iralabdisco/otto_stm32/electronics/otto_shield/otto_shield.kicad_pcb

## KiCad design electronics/otto_shield/otto_shield.kicad_pcb (2020-03-15)

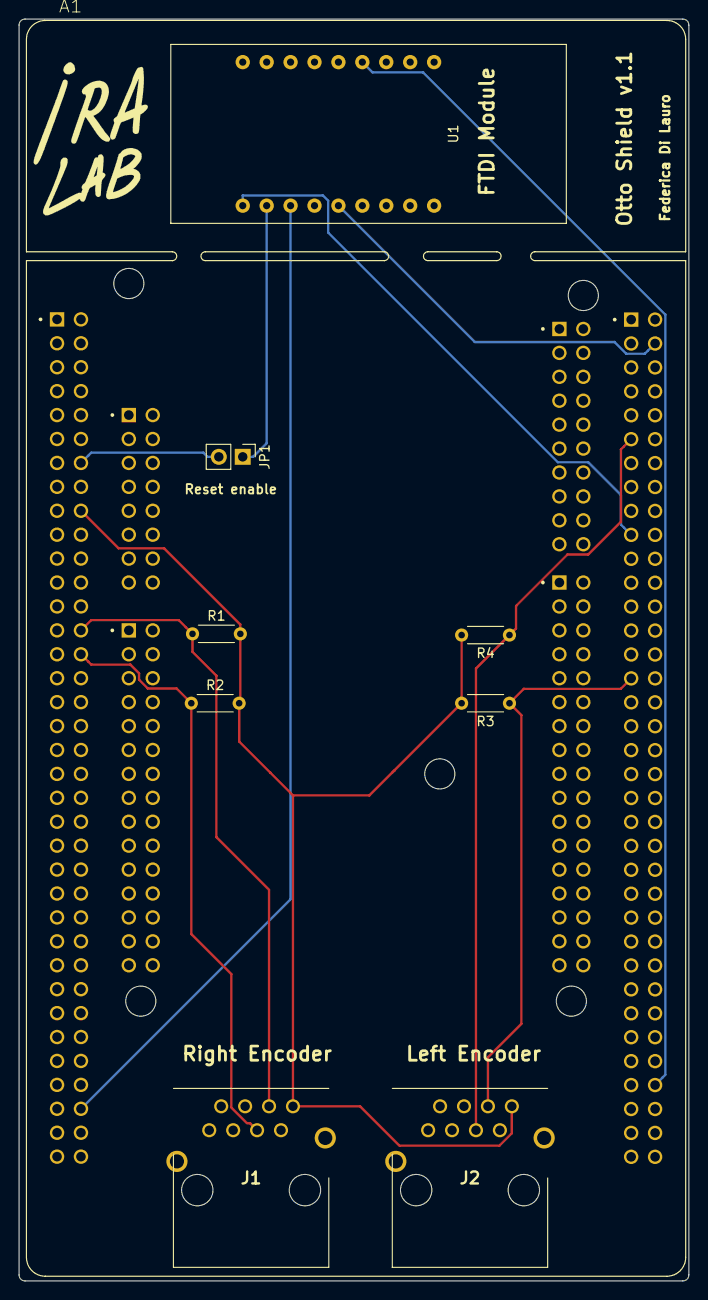
[picture p1: board otto_shield.kicad_pcb from above]

Board: 2 copper layers, 71.1 x 134.0 mm, 9 parts (0 on the bottom side), 12 nets.

Parts:
A1: NUCLEO-F767ZI; ST_NUCLEO-F767ZI
J1, J2: 3-5338556-1; 353385561
JP1: Jumper; PinHeader_1x02_P2.54mm_Vertical
R1, R2, R3, R4: 2.7K; R_Axial_DIN0204_L3.6mm_D1.6mm_P5.08mm_Horizontal
U1: az_serial_module

Connections:
+5V: A1.CN11_18, J1.1, J2.1, R1.2, R2.2, R3.2, R4.2
/RESET: A1.CN11_14, JP1.2
/TIM2_CH1: A1.CN12_11, J2.4, R4.1
/TIM2_CH2: A1.CN12_31, J2.3, R3.1
/TIM5_CH1: A1.CN11_28, J1.3, R1.1
/TIM5_CH2: A1.CN11_30, J1.4, R2.1
/USART_CTS: A1.CN11_68, U1.16
/USART_RTS: A1.CN12_66, U1.4
/USART_RX: A1.CN12_19, U1.18
/USART_TX: A1.CN12_4, U1.14
GND: A1.CN11_8, A1.CN11_19, A1.CN11_20, A1.CN11_22, A1.CN11_49, A1.CN11_60, A1.CN11_71, A1.CN11_72, A1.CN12_9, A1.CN12_20, A1.CN12_39, A1.CN12_54, A1.CN12_63, A1.CN12_71, A1.CN12_72, J1.2, J1.MH3, J1.MH4, J2.2, J2.MH3, J2.MH4, U1.9, U1.12
unnamed: JP1.1, U1.17
