iralabdisco/otto_stm32/(threads)

Thread 51 (2024-05-23):

Sistemare repo e wiki

fdila, 2024-05-23:
Da capire dove mettere le varie robe di connessione/wiring, se qui o in otto_wiki, e farlo.

Le cose che sono sulla wiki ora sono vecchie e deprecate.

Thread 52 (2024-06-24):

adc

lrivara, 2024-06-24:
Non riesco a capire perchè le misure prese dalle adc sono completamente diverse. Una ha un range di 80-100 e l'altra di 40-50. Come mai? @fdila @sorrenti

fdila, 2024-06-25:
Ci sono un po' troppe poche informazioni per darti una risposta :)

Cosa c'è collegato agli adc, i pin di current sense del pololu?
Hai provato prima a togliere il pololu e a mettere in input degli adc una tensione nota (che so, tipo i 1.5V di una pila AAA) e vedere se il valore che leggi sull'adc è quello che ti aspetti?

lrivara, 2024-06-25:
Cosa c'è collegato agli adc, i pin di current sense del pololu?
si
Hai provato prima a togliere il pololu e a mettere in input degli adc una tensione nota (che so, tipo i 1.5V di una pila AAA) e vedere se il valore che leggi sull'adc è quello che ti aspetti?
no, ma come faccio ad inserire una batteria, con un filo di rame?

fdila, 2024-06-25:
Sì con una pila da 1.5, collegando il - al GND della nucleo e il + al pin di adc dovresti leggere la tensione della pila, anche se sarebbe più carino avere un piccolo generatore di segnali, se ci sei domani ti porto il mio.
In alternativa puoi prendere multimetro/oscilloscopio e guardare la tensione che esce dai pin CS pololu e vedere se corrisponde a quello che leggi dalla nucleo.

lrivara, 2024-06-25:
domani ci sono per che ora devo farmi trovare?

lrivara, 2024-06-26:
Sono riuscito a vedere il voltaggio dell'onda ma anche cambiando le impostazioni del generatore l' onda è sempre troppo alta.
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

lrivara, 2024-06-26:
Ho misurato con l'oscilloscopio i pin current sense del pololu
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
Queste sono le misurazioni dei due pin quando i motori sono in funzione

fdila, 2024-06-27:
> Si vede anche dall'oscilloscopio che un pin va ad un voltaggio quasi il doppio dell'altro
Se converti il delta tra i due in corrente assorbita dai motori quanto sarebbe? Magari è ragionevole che si sia qualche milliampere di differenza (ma su questo lascio la parola al prof).

Extra che mi è venuto in mente ora: non è che quegli "spike" di corrente corrispondono in qualche modo al segnale PWM?
Prova ad attaccare anche i pin del PWM all'oscilloscopio e vediamo se effettivamente è così, tra l'altro era una cosa che se non ricordo male interessava anche a @sorrenti

lrivara, 2024-06-27:
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
Il canale giallo è il pwm e quello blu il current sense

lrivara, 2024-06-27:
Se converti il delta tra i due in corrente assorbita dai motori quanto sarebbe?
 18,4 mV- 11,2mV = 7,2 mV
7,2 mV /  20 mV/A = 0,36 A
anche se la documentazione dice che 20 mV/A sono solo approssimati

fdila, 2024-06-27:
> anche se la documentazione dice che 20 mV/A sono solo approssimati

A questo punto mi preoccuperei poco di questa discrepanza tra i due canali visto che è un pochino prevista.

A seguito dell'immagine sopra direi che forse ci avevo preso sul pwm.
IMHO ci sono due/tre questioni:

1. Capire se quegli spike siano "normali" per come funzionano i motori DC, prova a googlare in attesa del prof. (purtroppo la mia conoscenza dei motori DC è scarsa)
2. Scrivere un simpatico firmware (a parte rispetto a quello di otto) per loggare a frequenza abbastanza elevata (dirie i 40khz che ci siamo detti) i dati dei due adc sul computer. Vedi tu se si riesce a star dietro alla trasmissione sulla seriale visto che sono solo due numeri a 40khz, o se c'è abbastanza spazio sulla flash della schedina ti puoi anche far un buffer per loggare tot ms di adc e poi mandare tutto insieme alla fine.
Ad occhio il segnale non è male ma potrebbe essere utile comunque filtrarlo. Per esperienza personale fare le prove su come scrivere e tunare il filtro è decisamente più facile se fatto da pc sui dati raccolti, piuttosto che sul microcontrollore.
3. In parallelo approfondire/verificare l'utilizzo dell'adc con l'uso di un timer per campionare il segnale ad una frequenza stabilita ed integrare questa cosa su firmware otto.

lrivara, 2024-06-28:
Ho trovato un programma della ST che si chiama STM32CubeMonitor. Ho provato ad usarlo e questo è il risultato
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

fdila, 2024-07-01:
> Ho trovato un programma della ST che si chiama STM32CubeMonitor. Ho provato ad usarlo per vedere le variabili delle adc e questo è il risultato ( ho mandato i motori a metà della potenza massima ) 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

Bello! Ma riesci a vedere/campionare i dati alla frequenza che ci aspettiamo? Quindi in un secondo di registrazione dovresti trovarti 40000 campioni per ogni canale.

lrivara, 2024-07-08:
#Bello! Ma riesci a vedere/campionare i dati alla frequenza che ci aspettiamo? Quindi in un secondo di registrazione dovresti trovarti 40000 campioni per ogni canale.

> > Ho trovato un programma della ST che si chiama STM32CubeMonitor. Ho provato ad usarlo per vedere le variabili delle adc e questo è il risultato ( ho mandato i motori a metà della potenza massima ) 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
>
> Bello! Ma riesci a vedere/campionare i dati alla frequenza che ci aspettiamo? Quindi in un secondo di registrazione dovresti trovarti 40000 campioni per ogni canale.

no, ho visto adesso che riesce al massimo a 1khz

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

questo è il massimo che può fare

Thread 53 (2024-06-24):

Comunicazione seriale

lrivara, 2024-06-24:
Con @sorrenti avevamo deciso di prendere i dati di una adc per due cicli del pwm. Sono fermo perchè non riesco a inviare i dati tramite la comunicazione seriale. Ho provato a cambiare lo script di python ma non sono riuscito a farlo funzionare. @fdila sai come posso risolvere?

fdila, 2024-06-25:
Ci sono un po' troppe poche informazioni per darti una risposta :)

Cosa hai cambiato per inviare i dati, e cosa stai inviando e leggendo? Hai cambiato tutti i buffer aggiungendo i nuovi dati?

Per la parte di script python in realtà dovresti guardarti un minimo come funziona ROS 2 (qui ci sono i tutorial: https://docs.ros.org/en/humble/Tutorials.html ), il riassunto molto breve è che se hai cambiato lo script python senza "ri-buildare" il pacchetto ROS le modifiche che hai fatto non sono prese in considerazione.
Il tldr per vedere al volo se il problema è quello descritto sopra è andare nella cartella `drivers_ws`, fare `colcon build` e poi `source/install.bash`, e poi lanciare il comando per lanciare il driver.

Thread 54 (2024-07-22):

Encoder

lrivara, 2024-07-22:
Mi sono venute in mente delle soluzioni per il problema del vedere se l' encoder è staccato o no.

1)  vedere se quando l' encoder segnala 0 l' adc è più di 200. Perché se il motore è in stallo dovrebbe aumentare la tensione.

2) cambiare la componente integrale con la media esponenziale come si era detto per il controllo incrociato. Così facendo il valore del pwm dopo qualche iterazione dovrebbe andare a 0.

3) fare un controllo di routine iniziale  che manda un valore costante di pwm e controlla che l' encoder risponda

fdila, 2024-07-22:
Ciao,
IMHO la soluzione "più carina" è la 2. (e magari integrerei il controllo "si è staccato l'encoder" direttamente a livello di PID andando a vedere se in tot iterazioni di PID il feedback è sempre rimasto a 0).
La 1 potrebbe funzionare (sperando che per caso fortuito non si rompa l'ADC), così come funziona quello che hai fatto ora, anche se mi piange il cuore perchè è un po' bruttino dal punto di vista ing software.

La 3 la escluderei, è vero che ci salva dai casi in cui partiamo con l'encoder staccato, ma se per caso fortuito si stacca qualcosa mentre andiamo poi non ce ne riusciamo ad accorgere.
