iralabdisco/otto_stm32/otto_controller/Core/Src/main.cpp

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
/* Includes ------------------------------------------------------------------*/
#include "main.h"
#include "crc.h"
#include "dma.h"
#include "tim.h"
#include "usart.h"
#include "gpio.h"

/* USER CODE BEGIN Includes */

#include "control/encoder.h"
#include "control/odometry.h"
#include "control/motor_controller.h"
#include "control/pid.h"

#include "communication/otto_messages.h"

/* USER CODE END Includes */


/* USER CODE BEGIN PV */

//Odometry
Encoder right_encoder;
Encoder left_encoder;
Odometry odom;

//PID
Pid left_pid;
Pid right_pid;
Pid cross_pid;

//MotorController
MotorController right_motor(sleep1_GPIO_Port,
sleep1_Pin,
                            dir1_GPIO_Port,
                            dir1_Pin,
                            &htim4, TIM_CHANNEL_4);
MotorController left_motor(sleep2_GPIO_Port,
sleep2_Pin,
                           dir2_GPIO_Port,
                           dir2_Pin,
                           &htim4, TIM_CHANNEL_3);

//Communication
ConfigMessage config_msg;
VelocityMessage vel_msg;
StatusMessage status_msg;

volatile int32_t left_ticks;
volatile int32_t right_ticks;
volatile float previous_tx_millis;
volatile uint8_t tx_done_flag = 1;
volatile uint16_t otto_status = 0;

/* USER CODE END PV */

void SystemClock_Config(void);
static void MX_NVIC_Init(void);
/**
 * @brief  The application entry point.
 * @retval int
 */
int main(void) {
  /* MCU Configuration--------------------------------------------------------*/

  /* Reset of all peripherals, Initializes the Flash interface and the Systick. */
  HAL_Init();

  /* Configure the system clock */
  SystemClock_Config();

  /* Initialize all configured peripherals */
  MX_GPIO_Init();
  MX_DMA_Init();
  MX_TIM2_Init();
  MX_TIM4_Init();
  MX_TIM5_Init();
  MX_USART6_UART_Init();
  MX_TIM6_Init();
  MX_CRC_Init();

  /* Initialize interrupts */
  MX_NVIC_Init();
  /* USER CODE BEGIN 2 */

  //wait for config
  HAL_StatusTypeDef config_status = HAL_UART_Receive(&huart6, (uint8_t*) &config_msg, sizeof(config_msg), 60*1000);
  uint32_t config_crc = HAL_CRC_Calculate(&hcrc, (uint32_t*) &config_msg, sizeof(config_msg) - 4);
  if (config_crc != config_msg.crc || config_status != HAL_OK){
    status_msg.status = 2;
    status_msg.crc = HAL_CRC_Calculate(&hcrc, (uint32_t*) &status_msg, sizeof(status_msg) - 4);
    while(1){
      HAL_UART_Transmit(&huart6, (uint8_t*) &status_msg, sizeof(status_msg), 1000);
    }
  }

  left_encoder = Encoder(&htim2, config_msg.left_wheel_circumference,
                         config_msg.ticks_per_revolution);
  right_encoder = Encoder(&htim5, config_msg.right_wheel_circumference,
                           config_msg.ticks_per_revolution);

  odom = Odometry(config_msg.baseline);

  left_encoder.Setup();
  right_encoder.Setup();

  left_motor.Setup();
  right_motor.Setup();

  //right and left motors have the same parameters
  uint32_t max_dutycycle = *(&htim4.Instance->ARR);
  int pid_min = 0;
  int pid_max = 0;
  pid_min = -(int) max_dutycycle;
  pid_max = (int) max_dutycycle;

  left_pid.Config(config_msg.kp_left, config_msg.ki_left, config_msg.kd_left, pid_min, pid_max);
  right_pid.Config(config_msg.kp_right, config_msg.ki_right, config_msg.kd_right, pid_min, pid_max);
  cross_pid.Config(config_msg.kp_cross, config_msg.ki_cross, config_msg.kd_cross, pid_min, pid_max);

  left_motor.Coast();
  right_motor.Coast();

  //Enables TIM6 interrupt (used for PID control)
  HAL_TIM_Base_Start_IT(&htim6);

  //Enables UART RX interrupt
  HAL_UART_Receive_DMA(&huart6, (uint8_t*) &vel_msg, 12);

  /* USER CODE END 2 */

  /* Infinite loop */
  /* USER CODE BEGIN WHILE */
  while (1) {
    /* USER CODE END WHILE */

    /* USER CODE BEGIN 3 */
  }
  /* USER CODE END 3 */
}

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
/* USER CODE BEGIN 4 */
void HAL_TIM_PeriodElapsedCallback(TIM_HandleTypeDef *htim) {

  //TIMER 100Hz PID control

  //accumulate ticks for transmission
  left_ticks += left_encoder.GetCount();
  right_ticks += right_encoder.GetCount();

  //PID control
  float left_velocity = left_encoder.GetLinearVelocity();
  int left_dutycycle = left_pid.Update(left_velocity);

  float right_velocity = right_encoder.GetLinearVelocity();
  int right_dutycycle = right_pid.Update(right_velocity);

  float difference = left_velocity - right_velocity;
  int cross_dutycycle = cross_pid.Update(difference);

  left_dutycycle += cross_dutycycle;
  right_dutycycle -= cross_dutycycle;

  left_motor.SetSpeed(left_dutycycle);
  right_motor.SetSpeed(right_dutycycle);

}

uint8_t porcoddio = 0;
void HAL_UART_RxCpltCallback(UART_HandleTypeDef *UartHandle) {
  /*
   * Manage received message
   */

  uint32_t crc_rx = HAL_CRC_Calculate(&hcrc, (uint32_t*) &vel_msg, 8);

  float linear_velocity;
  float angular_velocity;

  if (crc_rx == vel_msg.crc) {
    linear_velocity = vel_msg.linear_velocity;
    angular_velocity = vel_msg.angular_velocity;
    otto_status = 1;
  } else {
    linear_velocity = 0;
    angular_velocity = 0;
    otto_status = 3;
  }

  odom.FromCmdVelToSetpoint(linear_velocity, angular_velocity);

  float left_setpoint = odom.GetLeftVelocity();
  float right_setpoint = odom.GetRightVelocity();

  left_pid.Set(left_setpoint);
  right_pid.Set(right_setpoint);

  float cross_setpoint = left_setpoint - right_setpoint;
  cross_pid.Set(cross_setpoint);

  /*
   * Manage new transmission
   */

  int32_t left_ticks_tx = left_ticks + left_encoder.GetCount();
  int32_t right_ticks_tx = right_ticks + right_encoder.GetCount();

  status_msg.left_ticks = left_ticks_tx;
  status_msg.right_ticks = right_ticks_tx;

  left_ticks = 0;
  right_ticks = 0;

  float current_tx_millis = HAL_GetTick();
  status_msg.delta_millis = current_tx_millis - previous_tx_millis;
  previous_tx_millis = current_tx_millis;

  status_msg.status = otto_status;

  uint32_t crc_tx = HAL_CRC_Calculate(&hcrc, (uint32_t*) &status_msg, 12);

  status_msg.crc = crc_tx;

  if (tx_done_flag == 1) {
    HAL_UART_Transmit_DMA(&huart6, (uint8_t*) &status_msg, sizeof(status_msg));
    tx_done_flag = 0;
  }

  HAL_UART_Receive_DMA(&huart6, (uint8_t*) &vel_msg, sizeof(vel_msg));
}


void HAL_UART_TxCpltCallback(UART_HandleTypeDef *UartHandle) {
  tx_done_flag = 1;
}

uint8_t uart_err = 0;
void HAL_UART_ErrorCallback(UART_HandleTypeDef *UartHandle) {
  uart_err += 1;
}

void HAL_GPIO_EXTI_Callback(uint16_t GPIO_Pin) {
  //Blue user button on the NUCLEO board
  if (GPIO_Pin == user_button_Pin) {
    //TODO ci può servire il bottone blu?
  } else if (GPIO_Pin == fault1_Pin) {
    left_motor.Brake();
    right_motor.Brake();
    //stop TIM6 interrupt (used for PID control)
    HAL_TIM_Base_Stop_IT(&htim6);
    otto_status = 4;
  } else if (GPIO_Pin == fault2_Pin) {
    left_motor.Brake();
    right_motor.Brake();
    //stop TIM6 interrupt (used for PID control)
    HAL_TIM_Base_Stop_IT(&htim6);
    otto_status = 4;
  }

}
/* USER CODE END 4 */
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
