iralabdisco/otto_stm32/otto_controller/otto_controller.ioc

Mcu.UserName=STM32F767ZITx
PA0/WKUP.GPIO_Label=encoder_dx1
PA0/WKUP.Signal=S_TIM5_CH1
PA1.GPIO_Label=encoder_dx2
PA1.Signal=S_TIM5_CH2
PA13.Signal=SYS_JTMS-SWDIO
PA14.Signal=SYS_JTCK-SWCLK
PA3.GPIO_Label=current1
PA3.Signal=GPIO_Analog
PA5.GPIO_Label=encoder_sx1
PA5.Signal=S_TIM2_CH1_ETR
PA6.GPIO_Label=fault2
PA6.Signal=GPXTI6
PB3.GPIO_Label=encoder_sx2
PB3.Signal=S_TIM2_CH2
PC0.GPIO_Label=current2
PC0.Signal=GPIO_Analog
PC13.GPIO_Label=user_button
PC13.Signal=GPXTI13
PC6.Signal=USART6_TX
PC7.Signal=USART6_RX
PD14.GPIO_Label=pwm2
PD14.Signal=S_TIM4_CH3
PD15.GPIO_Label=pwm1
PD15.Signal=S_TIM4_CH4
PE9.GPIO_Label=fault1
PE9.Signal=GPXTI9
PF12.GPIO_Label=dir2
PF12.Signal=GPIO_Output
PF13.GPIO_Label=dir1
PF13.Signal=GPIO_Output
PF14.GPIO_Label=sleep2
PF14.Signal=GPIO_Output
PF15.GPIO_Label=sleep1
PF15.Signal=GPIO_Output
