iralabdisco/otto_stm32/otto_controller/Core/Inc/control/motor_controller.h

#ifndef MOTOR_CONTROLLER_H
#define MOTOR_CONTROLLER_H

#include "main.h"

class MotorController {
 private:
  GPIO_TypeDef *sleep_gpio_port_;
  uint16_t sleep_pin_;
  GPIO_TypeDef *dir_gpio_port_;
  uint16_t dir_pin_;
  TIM_HandleTypeDef *pwm_timer_;
  uint32_t pwm_channel_;
  int32_t max_dutycycle_;

 public:
  MotorController(GPIO_TypeDef *sleep_gpio_port, uint16_t sleep_pin,
                  GPIO_TypeDef *dir_gpio_port, uint16_t dir_pin,
                  TIM_HandleTypeDef *pwm_timer, uint32_t pwm_channel) {
    this->sleep_gpio_port_ = sleep_gpio_port;
    this->sleep_pin_ = sleep_pin;
    this->dir_gpio_port_ = dir_gpio_port;
    this->dir_pin_ = dir_pin;
    this->pwm_timer_ = pwm_timer;
    this->pwm_channel_ = pwm_channel;
    this->max_dutycycle_ = 0;
  }

  void Setup() {
    HAL_TIM_PWM_Start(pwm_timer_, pwm_channel_);
    this->max_dutycycle_ = pwm_timer_->Instance->ARR;
  }

  void SetSpeed(int duty_cycle) {
    if (duty_cycle >= 0) {
      //set direction to forward
      HAL_GPIO_WritePin(dir_gpio_port_, dir_pin_, GPIO_PIN_SET);

      //check if duty_cycle exceeds maximum
      if (duty_cycle > max_dutycycle_)
        __HAL_TIM_SET_COMPARE(pwm_timer_, pwm_channel_, max_dutycycle_);
      else
        __HAL_TIM_SET_COMPARE(pwm_timer_, pwm_channel_, duty_cycle);

    } else if (duty_cycle < 0){
      //set direction to backwards
      HAL_GPIO_WritePin(dir_gpio_port_, dir_pin_, GPIO_PIN_RESET);

      //check if duty_cycle is lower than minimum
      if (duty_cycle < -max_dutycycle_)
        __HAL_TIM_SET_COMPARE(pwm_timer_, pwm_channel_, max_dutycycle_);
      else
        //invert sign to make duty_cycle positive
      __HAL_TIM_SET_COMPARE(pwm_timer_, pwm_channel_, -duty_cycle);
    }

    HAL_GPIO_WritePin(sleep_gpio_port_, sleep_pin_, GPIO_PIN_SET);

  }

  void Brake() {
    HAL_GPIO_WritePin(sleep_gpio_port_, sleep_pin_, GPIO_PIN_SET);
    __HAL_TIM_SET_COMPARE(pwm_timer_, pwm_channel_, 0);
  }

  void Coast() {
    HAL_GPIO_WritePin(sleep_gpio_port_, sleep_pin_, GPIO_PIN_RESET);
  }
};
#endif
