iralabdisco/otto_stm32/otto_controller/Core/Inc/main.h

#define user_button_Pin GPIO_PIN_13
#define user_button_GPIO_Port GPIOC
#define user_button_EXTI_IRQn EXTI15_10_IRQn
#define current2_Pin GPIO_PIN_0
#define current2_GPIO_Port GPIOC
#define encoder_dx1_Pin GPIO_PIN_0
#define encoder_dx1_GPIO_Port GPIOA
#define encoder_dx2_Pin GPIO_PIN_1
#define encoder_dx2_GPIO_Port GPIOA
#define current1_Pin GPIO_PIN_3
#define current1_GPIO_Port GPIOA
#define encoder_sx1_Pin GPIO_PIN_5
#define encoder_sx1_GPIO_Port GPIOA
#define fault2_Pin GPIO_PIN_6
#define fault2_GPIO_Port GPIOA
#define dir2_Pin GPIO_PIN_12
#define dir2_GPIO_Port GPIOF
#define dir1_Pin GPIO_PIN_13
#define dir1_GPIO_Port GPIOF
#define sleep2_Pin GPIO_PIN_14
#define sleep2_GPIO_Port GPIOF
#define sleep1_Pin GPIO_PIN_15
#define sleep1_GPIO_Port GPIOF
#define fault1_Pin GPIO_PIN_9
#define fault1_GPIO_Port GPIOE
#define pwm2_Pin GPIO_PIN_14
#define pwm2_GPIO_Port GPIOD
#define pwm1_Pin GPIO_PIN_15
#define pwm1_GPIO_Port GPIOD
#define encoder_sx2_Pin GPIO_PIN_3
#define encoder_sx2_GPIO_Port GPIOB
