iralabdisco/otto_stm32/otto_controller/Core/Inc/control/pid.h

#ifndef PID_H
#define PID_H

class Pid {
 private:
  //PID constants
  float kp_;
  float ki_;
  float kd_;

  float error_;
  float setpoint_;

  //needed for integrative term
  float error_sum_;

  //needed for derivative term
  float previous_error_;

  int min_;
  int max_;

 public:
  Pid() {
    this->kp_ = 0;
    this->ki_ = 0;
    this->kd_ = 0;

    this->error_ = 0;
    this->setpoint_ = 0;

    this->previous_error_ = 0;
    this->error_sum_ = 0;

    this->min_ = 0;
    this->max_ = 0;
  }
  Pid(float kp, float ki, float kd, int min, int max) {
    this->kp_ = kp;
    this->ki_ = ki;
    this->kd_ = kd;

    this->error_ = 0;
    this->setpoint_ = 0;

    this->previous_error_ = 0;
    this->error_sum_ = 0;

    this->min_ = min;
    this->max_ = max;

  }

  void Config(float kp, float ki, float kd, int min, int max) {
    this->kp_ = kp;
    this->ki_ = ki;
    this->kd_ = kd;

    this->error_ = 0;
    this->setpoint_ = 0;

    this->previous_error_ = 0;
    this->error_sum_ = 0;

    this->min_ = min;
    this->max_ = max;

  }

  void Set(float setpoint) {
    this->setpoint_ = setpoint;
  }

  int Update(float measure) {

    this->error_ = this->setpoint_ - measure;

    //proportional term
    float output = this->error_ * this->kp_;

    //integral term without windup
    error_sum_ += this->error_;
    output += error_sum_ * this->ki_;

    //derivative term
    output += (this->error_ - this->previous_error_) * kd_;
    this->previous_error_ = this->error_;

    int integer_output = static_cast<int>(output);

    //anti windup
    if (integer_output > this->max_) {
      integer_output = this->max_;
      this->error_sum_ -= this->error_;
    } else if (integer_output < this->min_) {
      integer_output = this->min_;
      this->error_sum_ -= this->error_;
    }

    return integer_output;

  }
};
#endif
