iralabdisco/otto_stm32/(commit log)

2019-07-26 Starting to learn about drivers, encoders and PID control
2019-09-03 test encoder working
    [encoder.elf.cfg]
2019-09-03 pwm first test
    [pwm.elf.cfg]
2019-09-06 pwm function
2019-09-11 config periferiche okok, da sistemare STM32Hardware.h
2019-09-19 encoder not compiling
2019-09-20 encoder tick reading and reset (working)
    [encoder.h, main.cpp, main.h]
2019-09-26 Start working on timer callback
2019-10-08 start reading velocity from encoder
2019-10-08 ticks to linear velocity
2019-10-09 encoder reading
2019-10-15 fix counter backward direction
    [otto_controller_source.elf.cfg]
2019-10-16 update to new firmware version broke the encoder readings
    [main.cpp]
2019-10-16 encoder resolution x2
2019-10-18 Reading velocity fixes, everything works now
    [main.cpp]
2019-10-18 Start odometry
2019-11-18 rosserial works, odometry si rompe
    [otto_controller_source Debug.cfg]
2019-11-22 rosserial works, testing odometry
    [otto_controller_source Debug.cfg, otto_controller_source.elf.cfg]
2019-12-02 add python script to receive from UART
    [otto_controller_source Debug.cfg]
2019-12-06 uart tests
2019-12-14 pid and motor_controller classes implemented
2019-12-14 pid control, to be tested
2019-12-15 fix interrupt prioriies
2019-12-15 fix communication for testing
    [encoder.h, main.cpp, motor_controller.h, odometry.h, pid.h]
2019-12-17 pid works, needs tuning
2019-12-17 pid derviative term
2019-12-18 pid: log dutycycle->velocity for matlab
    [left-motor-2019-12-18-11-55-33.csv, right-motor-2019-12-18-11-24-51.csv]
2020-01-20 move tools in a directory
    [left-motor-2019-12-18-11-55-33.csv, right-motor-2019-12-18-11-24-51.csv]
2020-01-20 organize code and folders
    [left-motor-2019-12-18-11-55-33.csv, otto_controller_source Debug.cfg, right-motor-2019-12-18-11-24-51.csv]
2020-01-20 swap left/right in pid_tuning
    [main.cpp, motor_controller.h, pid.h]
2020-01-22 fix pid, remove antiwindup, start code refactoring
    [encoder.h, main.cpp, motor_controller.h, pid.h]
2020-01-22 refactor pid
2020-01-23 fix motor_controller
    [otto_controller_source Debug.cfg]
2020-01-23 start ticks calibration, now otto can be driven with joystick!
2020-01-24 add ticks calibration tests and results
    [2020-01-24-test.ods]
2020-01-27 organize folders
    [2020-01-24-test.ods, 2test-2020-01-27-09-15-56.csv]
2020-01-27 update otto_controller and pid_tuning with new ticks calibration
2020-01-27 clean repo
    [left-motor-2019-12-18-11-55-33.csv, otto_controller_source Debug.cfg, right-motor-2019-12-18-11-24-51.csv]
2020-01-29 remove ticks_logger, encoders get the meters from wheel circumference (now measured accurately)
    [2020-01-24-test.ods, 2test-2020-01-27-09-15-56.csv]
2020-02-06 move encoder methods to header file
2020-02-06 remove old matlab
    [left-motor-2019-12-18-11-55-33.csv, right-motor-2019-12-18-11-24-51.csv]
2020-02-07 add pid anti windup to pid_tuning
2020-02-07 add pid antiwindup to otto_controller
2020-02-10 dma tests
2020-02-11 switch to protobuf v2
2020-02-11 dma works
2020-02-11 receiving velocities command using protobuf
2020-02-12 receive cmd_vel and send velocity with protobuf
2020-02-12 change transmission frequency to 10Hz
2020-02-25 change uart baud rate to 9600
2020-02-25 change status field in StatusMessage to fixed size
    [main.cpp, serial_receiver.py]
2020-03-02 print debug messages
2020-03-02 fix odometry
2020-03-02 add fault interrupts, fix #6
    [main.cpp, main.h, otto_controller.ioc]
2020-03-04 add hardware flow control for computer->st transmission
2020-03-06 add pcb #30
    [otto_shield.kicad_pcb, otto_shield.sch]
2020-03-09 change rj45 connector to shielded rj45
    [otto_shield.kicad_pcb, otto_shield.sch]
2020-03-09 remove temporary kicad files
2020-03-10 add kicad autogenerated files to gitignore
2020-03-15 remove throttle node, computer->st transmission works without it
2020-03-15 reset mcu from serial adapter
    [serial_receiver.py]
2020-03-15 add connection from the serial module to allow reset
    [otto_shield.kicad_pcb, otto_shield.sch]
2020-04-14 fix odometry error when going straight
    [serial_receiver.py]
2020-07-22 odometry bug fix, close #46
2021-08-10 New communication system (#49)
    * synchronous communication, remove protobuf
    * accumulate ticks to send
    * receive config parameters at startup, close #13
    * file cleanup
    * README.md
    * fix ticks type
    [encoder.h, main.cpp, main.h]
